Sinsisa/pixel-mood-lamp/hardware/control-board/Mood_Lamp_Control_Board_BOM_JLCPCB.csv

Comment | Designator | Footprint | LCSC Part # | Manufacturer Part Number | Quantity
10uF | C1,C2,C3 | C0805 | C15850 | CL21A106KAYNNNE | 3
22uF | C4,C5,C6,C7,C8,C9,C18,C19,C20 | C0805 | C380338 | TCC0805X5R226M100FT | 9
1uF | C10,C11,C12 | C0603 | C5673 | CL10A105KA8NNNC | 3
100nF | C13,C14,C15,C16 | C0603 | C490602 | C0603C104J5RAC7867 | 4
10nF | C17 | C0603 | C309036 | TCC0603X7R103K500CT | 1
1uF | C39 | C0603 | C445753 | C1608X7R1A105KT000E | 1
USBLC6-2SC6 | D1 | SOT-23-6_L2.9-W1.6-P0.95-LS2.8-BL | C7519 | USBLC6-2SC6 | 1
1uH | L1 | IND-SMD_L7.1-W6.5-P5.60 | C87572 | SPM6530T-1R0M120 | 1
2.2uH | L2 | L1008 | C576403 | DFE252012F-2R2M=P2 | 1
LTST-C193TBKT-5A | LED1,LED2,LED3,LED4 | LED0603-RD | C125103 | LTST-C193TBKT-5A | 4
5.1kΩ | R1,R2,R3,R4 | R0603 | C105580 | RC0603FR-075K1L | 4
22Ω | R5,R6 | R0603 | C23345 | 0603WAF220JT5E | 2
10kΩ | R7,R8,R11,R12 | R0603 | C25804 | 0603WAF1002T5E | 4
100kΩ | R9 | R0603 | C14675 | RC0603FR-07100KL | 1
68Ω | R10 | R0603 | C126362 | RC0603FR-0768RL | 1
MSK12C02-BB2.5 | SW1 | SW-SMD_MSK12C02G25-B | C47020938 | MSK12C02-BB2.5 | 1
TS-1187A-B-A-B | SW2,SW3,SW4 | SW-SMD_4P-L5.1-W5.1-P3.70-LS6.5-TL_H1.5 | C318884 | TS-1187A-B-A-B | 3
ESP32-C3-MINI-1-H4X | U1 | WIFIM-SMD_ESP32-C3-MINI-1 | C41349510 | ESP32-C3-MINI-1-H4X | 1
IP5306 | U2 | ESOP-8_L4.9-W3.9-P1.27-LS6.0-BL-EP | C181692 | IP5306 | 1
TPS22975DSGR | U3 | WSON-8_L2.0-W2.0-P0.50-TL-EP | C524777 | TPS22975DSGR | 1
TPS62162DSGR | U4 | WSON-8_L2.0-W2.0-P0.50-TL-EP | C40256 | TPS62162DSGR | 1
JL128-50803G01 | U5 | CONN-TH_JL128-50803G01 | C415423 | JL128-50803G01 | 1
JL128-50802G01 | U6 | CONN-TH_JL128-50802G01 | C415422 | JL128-50802G01 | 1
TYPE-C-31-M-12 | USBC1,USBC2 | USB-C_SMD-TYPE-C-31-M-12_1 | C165948 | TYPE-C-31-M-12 | 2
