Sinsisa/pixel-mood-lamp/hardware/led-panel/RGB_LED_Panel_Board_BOM.csv

Supplier | Supplier Part | Manufacturer | Manufacturer Part | Value | Footprint | Designator | Comment | Quantity | No.
LCSC | C88736 | Rubycon(çº¢å- çŸ³) | 16TZV470M8X10.5 |  | CAP-SMD_BD8.0-L8.3-W8.3-FD | C1 | 470uF | 1 | 1
LCSC | C126600 | muRata(æ ‘ç”°) | GCM31CR71C106KA64L |  | C1206 | C2 | 10uF | 1 | 2
LCSC | C52941389 | worldsemi | WS2812B-2427-V6 |  | LED-SMD_4P-L2.7-W2.4-P1.30_WS2812B-2427-V6 | L1,L2,L3,L4,L5,L6,L7,L8,L9,L10,L11,L12,L13,L14,L15,L16,L17,L18,L19,L20,L21,L22,L23,L24,L25,L26,L27,L28,L29,L30,L31,L32,L33,L34,L35,L36,L37,L38,L39,L40,L41,L42,L43,L44,L45,L46,L47,L48,L49,L50,L51,L52,L53,L54,L55,L56,L57,L58,L59,L60,L61,L62,L63,L64,L65,L66,L67,L68,L69,L70,L71,L72,L73,L74,L75,L76,L77,L78,L79,L80,L81,L82,L83,L84,L85,L86,L87,L88,L89,L90,L91,L92,L93,L94,L95,L96,L97,L98,L99,L100,L101,L102,L103,L104,L105,L106,L107,L108,L109,L110,L111,L112,L113,L114,L115,L116,L117,L118,L119,L120,L121,L122,L123,L124,L125,L126,L127,L128,L129,L130,L131,L132,L133,L134,L135,L136,L137,L138,L139,L140,L141,L142,L143,L144,L145,L146,L147,L148,L149,L150,L151,L152,L153,L154,L155,L156,L157,L158,L159,L160,L161,L162,L163,L164,L165,L166,L167,L168,L169,L170,L171,L172,L173,L174,L175,L176,L177,L178,L179,L180,L181,L182,L183,L184,L185,L186,L187,L188,L189,L190,L191,L192,L193,L194,L195,L196,L197,L198,L199,L200,L201,L202,L203,L204,L205,L206,L207,L208,L209,L210,L211,L212,L213,L214,L215,L216,L217,L218,L219,L220,L221,L222,L223,L224,L225 | WS2812B-2427-V6_C52941389 | 225 | 3
LCSC | C415423 | JILN(é”¦å‡Œ) | JL128-50803G01 |  | CONN-TH_JL128-50803G01 | P1 | JL128-50803G01 | 1 | 4
LCSC | C14675 | YAGEO(å›½å·¨) | RC0603FR-07100KL |  | R0603 | R1 | 100kÎ- | 1 | 5
LCSC | C9900168887 | null | Pad |  | TEST-SMD_BD1.9-L4.2 | TP1 | PAD_C9900168887 | 1 | 6
