Sinsisa/pixel-mood-lamp/hardware/enclosure/Back Plate.step

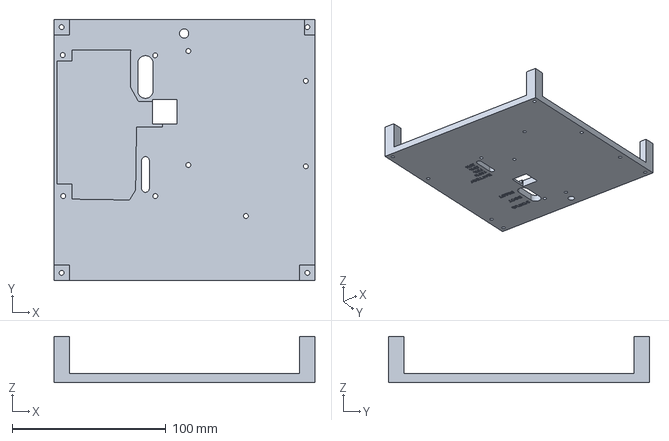
[picture p5: CAD file, 2026-11-02]
hardware/enclosure/Back Plate.step
170.0 x 170.0 x 30.0 mm
