Sinsisa/pixel-mood-lamp/hardware/enclosure/Light Grid.step

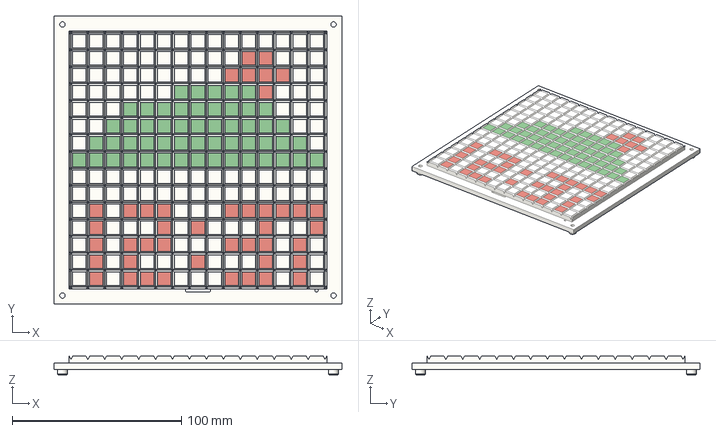
[picture p6: CAD file, 2026-11-02]
hardware/enclosure/Light Grid.step
170.0 x 170.0 x 11.0 mm
