Sinsisa/pixel-mood-lamp/hardware/enclosure/Battery Casing.step

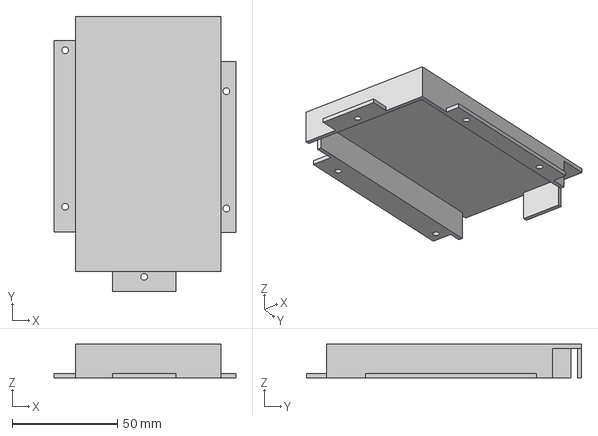
[picture p7: CAD file, 2026-11-02]
hardware/enclosure/Battery Casing.step
86.4 x 130.5 x 16.0 mm
