Sinsisa/pixel-mood-lamp/hardware/enclosure/Grid Cage [BLACK].step

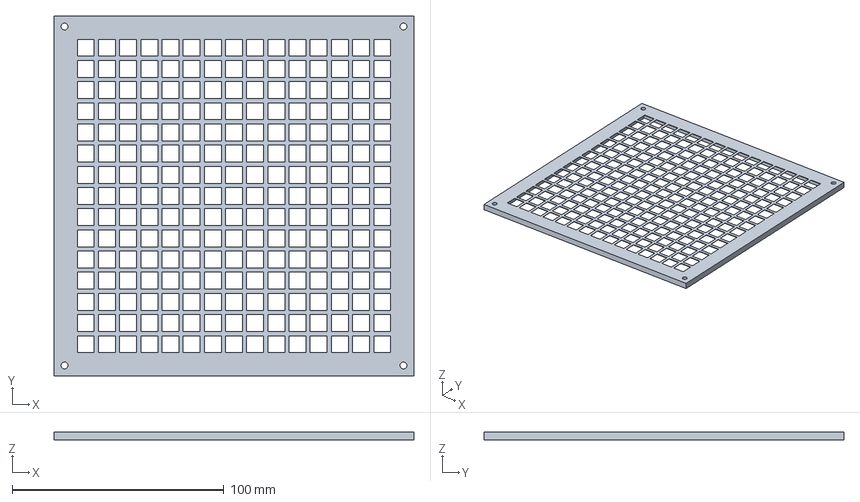
[picture p8: CAD file, 2026-11-02]
hardware/enclosure/Grid Cage [BLACK].step
170.0 x 170.0 x 4.00 mm
