Sinsisa/pixel-mood-lamp/hardware/enclosure/Light Plate.step

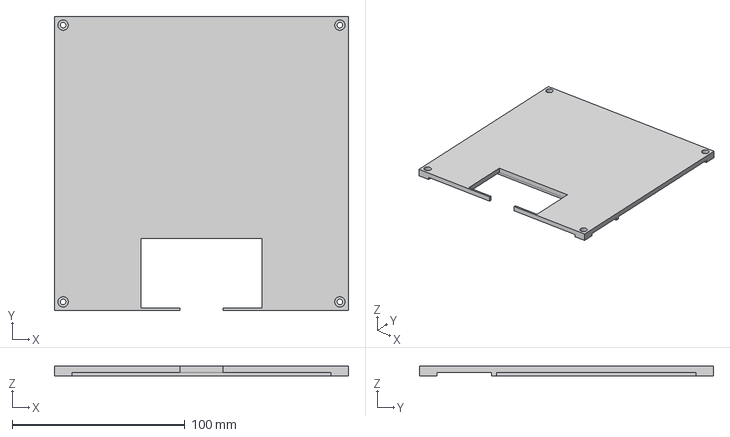
[picture p9: CAD file, 2026-11-02]
hardware/enclosure/Light Plate.step
170.0 x 170.0 x 6.00 mm
