Sinsisa/pixel-mood-lamp/hardware/enclosure/Casing.step

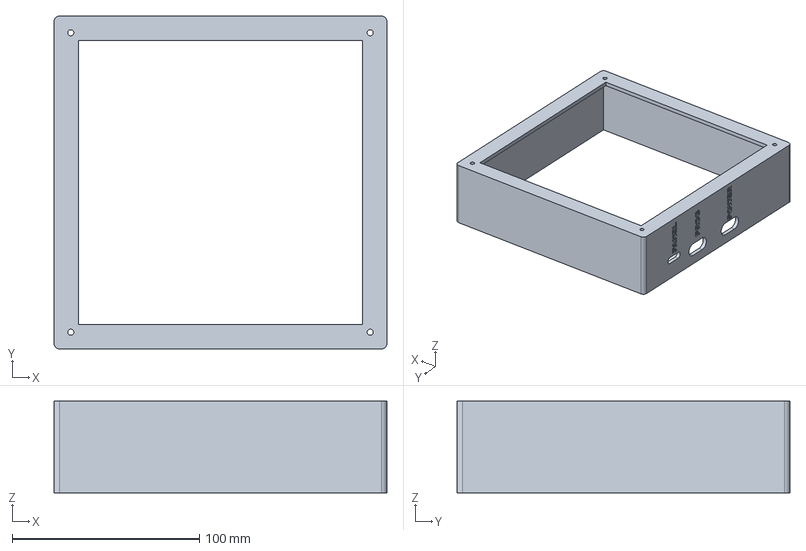
[picture p10: CAD file, 2026-11-02]
hardware/enclosure/Casing.step
178.0 x 178.0 x 49.0 mm
