Sinsisa/pixel-mood-lamp/(list of files, cad)

Other CAD files:
hardware/enclosure/Light Grid [TRANSLUCENT].step
