Sinsisa/pixel-mood-lamp/media/assembled-face.jpg

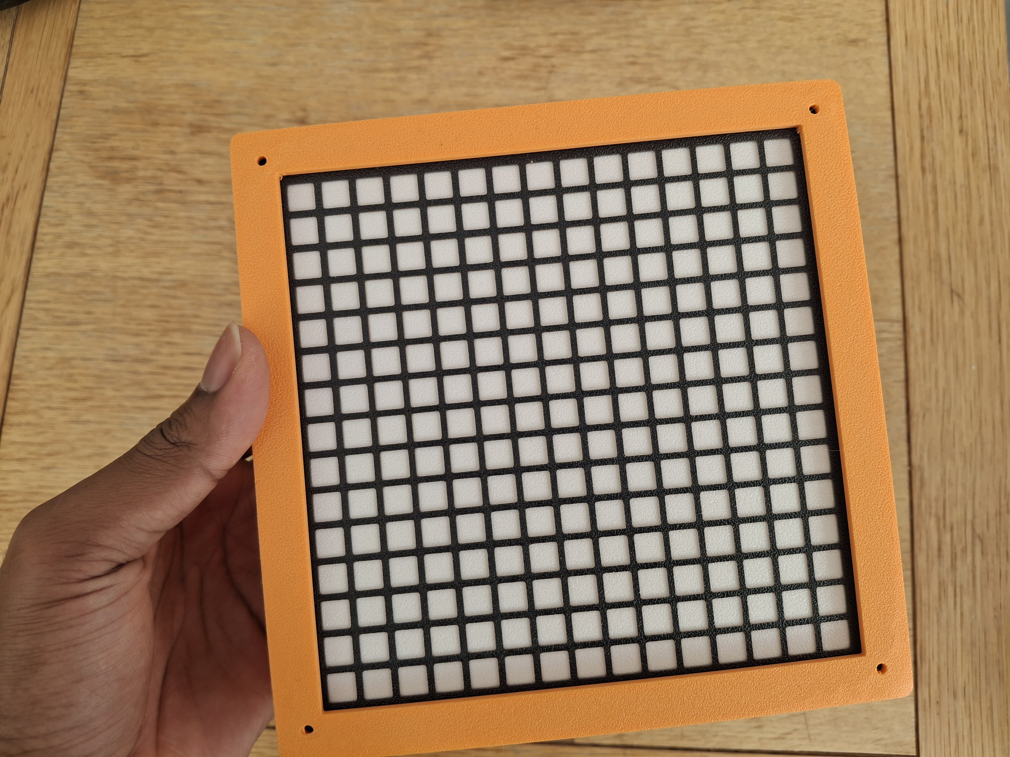
media/assembled-face.jpg
