Sinsisa/pixel-mood-lamp/(commit log)

2026-11-02 Release Pixel Mood Lamp panel, enclosure and animations
    [Back Plate.step, Battery Casing.step, Casing.step, Grid Cage [BLACK].step, Light Grid [TRANSLUCENT].step, Light Grid.step, Light Plate.step, ProjectATesting_Panel_BOM.csv]
2026-11-02 Add PCBWay LED panel project and support link
2026-11-05 Publish controller manufacturing files and use proper LED board names
    [Mood_Lamp_Control_Board_BOM_JLCPCB.csv, RGB_LED_Panel_Board_BOM.csv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]
